Equipe-SJBots/amalinha/Files/Códigos/Projetos de outras pessoas/SEGUIDOR/circuito seguidor.png

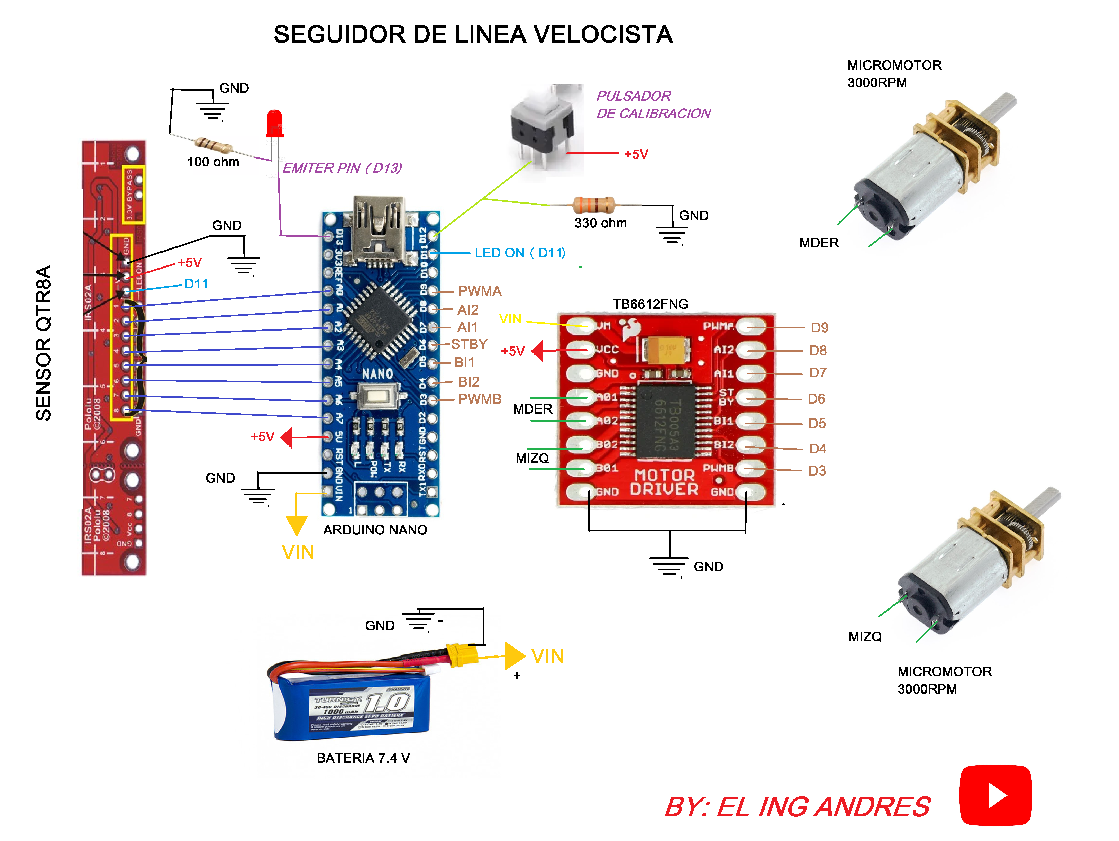
Files/Códigos/Projetos de outras pessoas/SEGUIDOR/circuito seguidor.png
