Equipe-SJBots/amalinha/README.md

# seguidor-de-linha
Códigos para o robô seguidor de linha
