Equipe-SJBots/amalinha/Files/Códigos/Projetos de outras pessoas/5IR-2Motores/README.md

# Line-Follower-Robot-using-5-Channel-IR

This github include the complete code and circuit diagram of the Line follower Project.
If you find the motors running in a wrong direction than just reverse the connection of the motors.
Queries can be mailed us on 2idiotsofengineering@gmail.com

- [Source](https://github.com/himanshus2847/Line-Follower-Robot-using-5-Channel-IR)
