Equipe-SJBots/amalinha/Files/Códigos/Projetos de outras pessoas/3 advanced_pid_control___bluetooth_communication/a.md

# Fonte

- [Hackster](https://www.hackster.io/anova9347/line-follower-robot-with-pid-controller-cdedbd)
