Equipe-SJBots/amalinha/Files/Códigos/Projetos de outras pessoas/PID-Line-Follower-Robot-main/source.md

# Fonte

- [Techno](https://github.com/theTechnowright/PID-Line-Follower-Robot)
