Equipe-SJBots/amalinha/Files/Códigos/Projetos de outras pessoas/5IR-2Motores/Diagrama.png

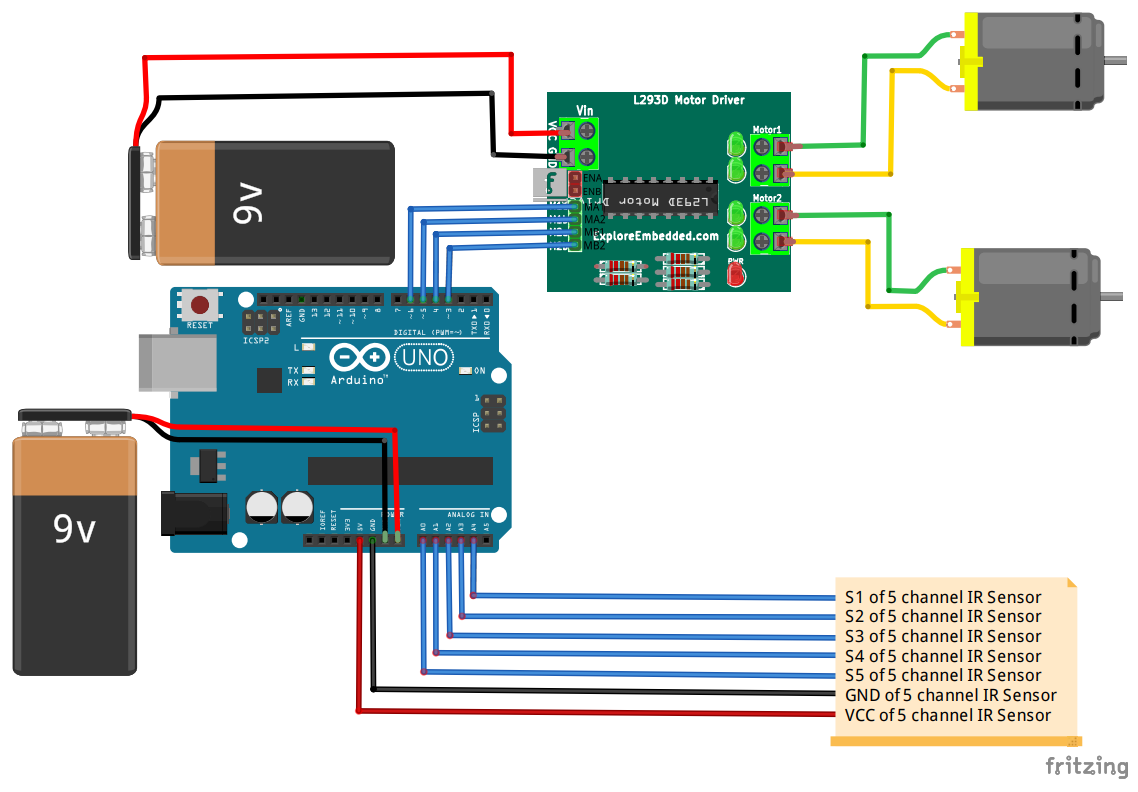
Files/Códigos/Projetos de outras pessoas/5IR-2Motores/Diagrama.png
