Equipe-SJBots/amalinha/Files/Esquema elétrico/20231111-DiagramaElétrico-Amalinha-5IR.png

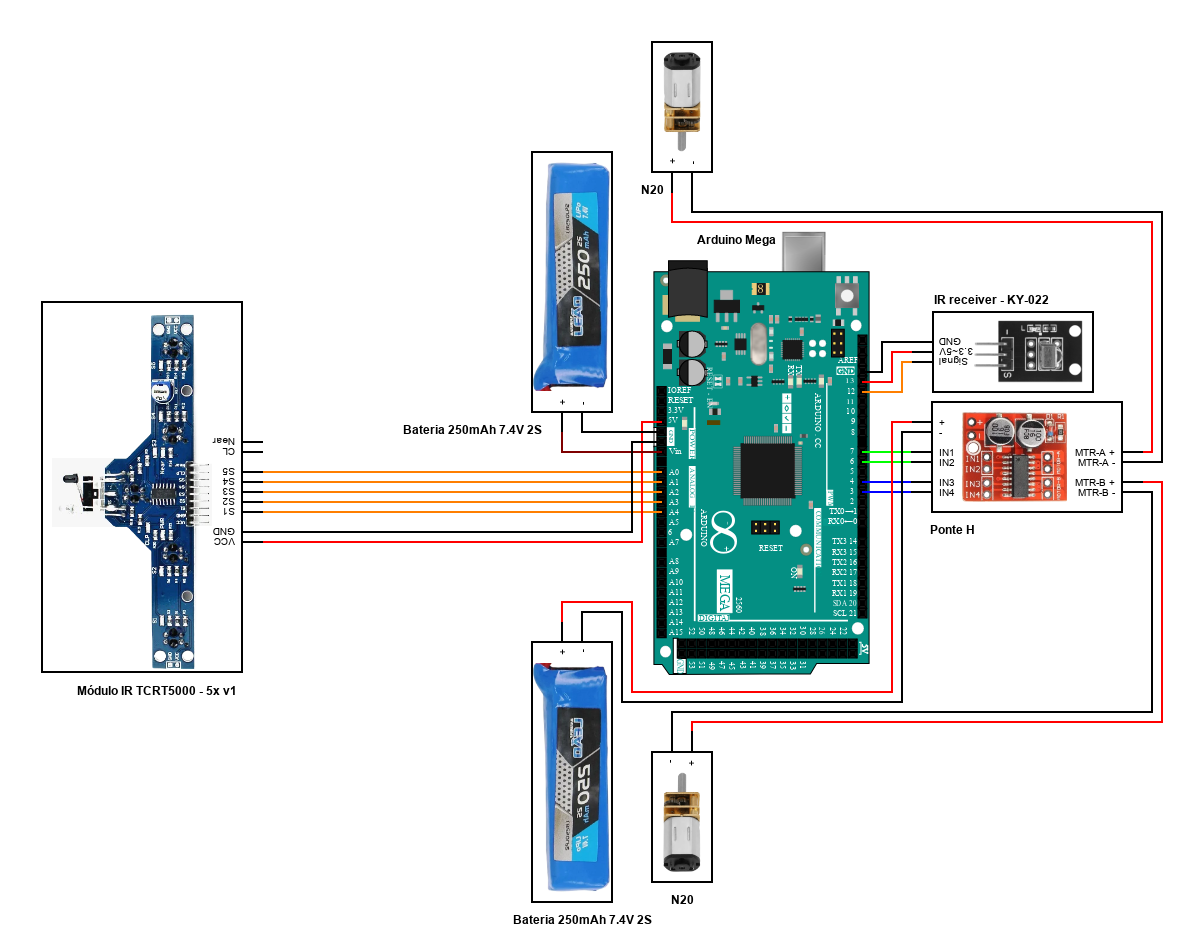
Files/Esquema elétrico/20231111-DiagramaElétrico-Amalinha-5IR.png
