Equipe-SJBots/amalinha/Files/Modelos/caster wheel v2.step

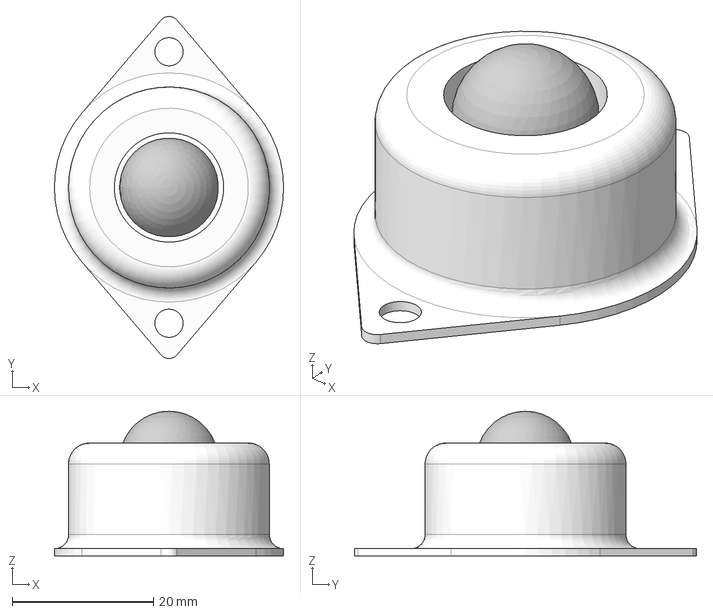
[picture p29: CAD file, 2023-11-14]
Files/Modelos/caster wheel v2.step
32.5 x 48.5 x 20.5 mm
Case
