Equipe-SJBots/amalinha/Files/Modelos/Caster Ball Wheel.STEP

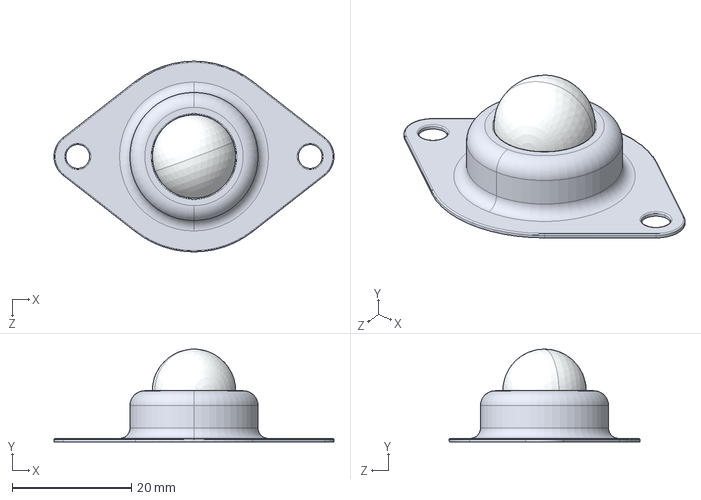
[picture p30: CAD file, 2023-11-14]
Files/Modelos/Caster Ball Wheel.STEP
47.0 x 15.6 x 32.0 mm
Wheel''s Body
Ball
