Equipe-SJBots/amalinha/(list of files, cad)

Other CAD files:
Files/Modelos/caster ball wheel.stl
Files/Modelos/caster wheel v2.stl
