Equipe-SJBots/amalinha/Files/Códigos/Projetos de outras pessoas/SEGUIDOR/IMPIRMIR/Untitled Sketch 2_etch_copper_bottom.pdf

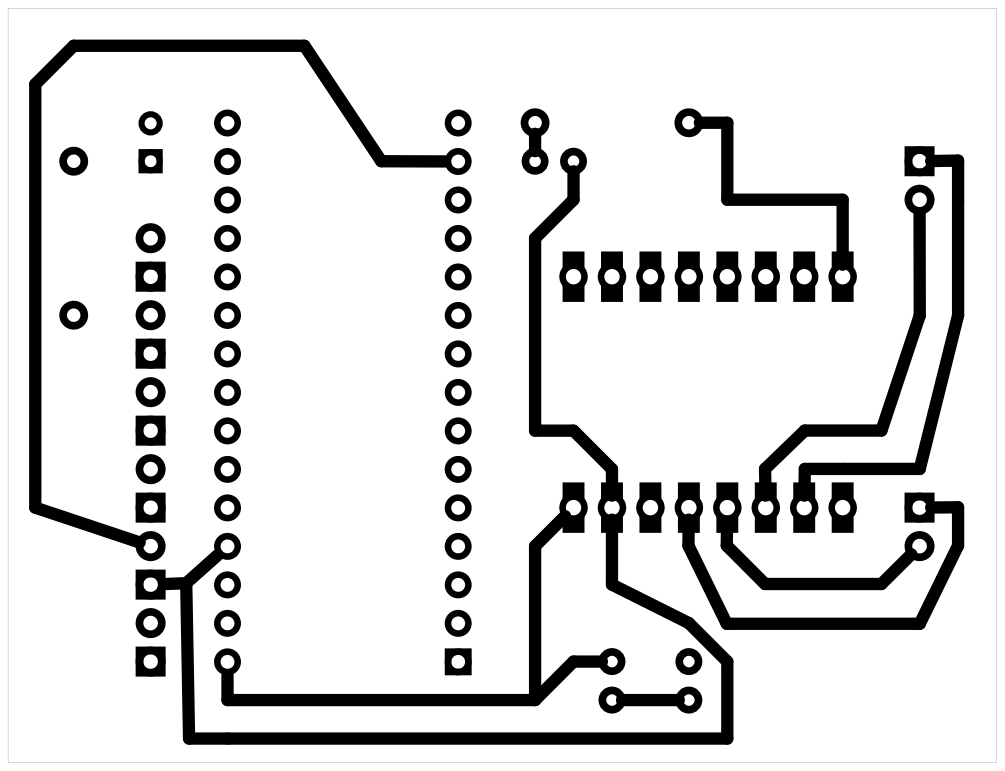
[picture p31: page 1]
