Equipe-SJBots/amalinha/Files/Códigos/Projetos de outras pessoas/SEGUIDOR/IMPIRMIR/Untitled Sketch 2_etch_copper_bottom_mirror.pdf

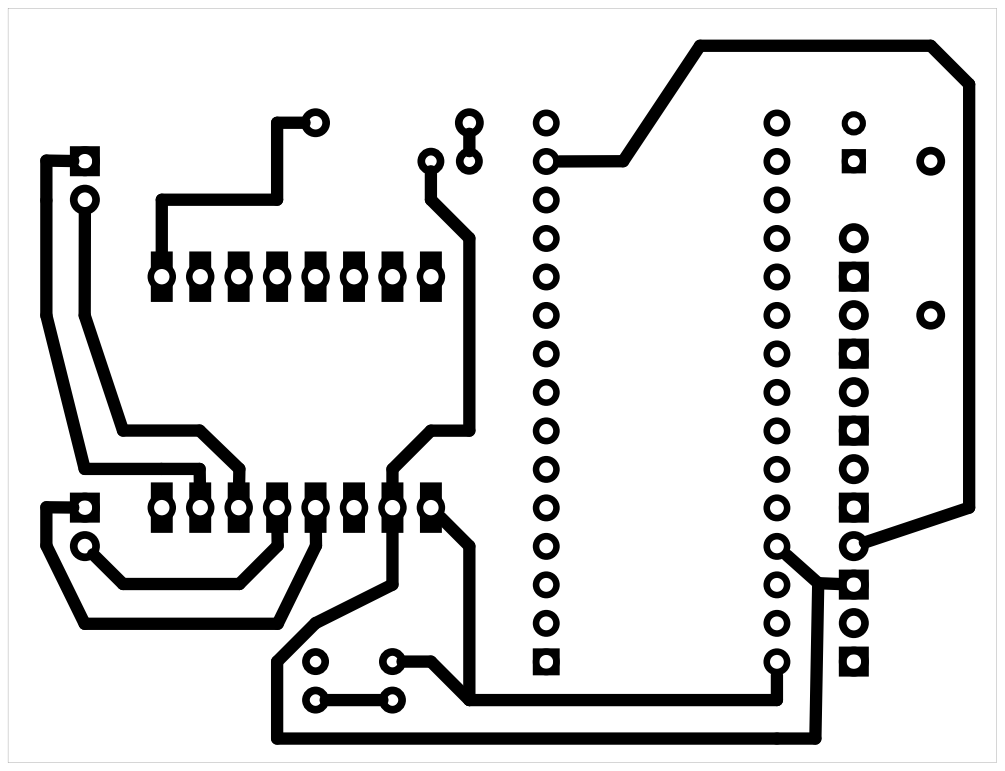
[picture p32: page 1]
