Equipe-SJBots/amalinha/Files/Códigos/Projetos de outras pessoas/SEGUIDOR/IMPIRMIR/Untitled Sketch 2_etch_copper_top.pdf

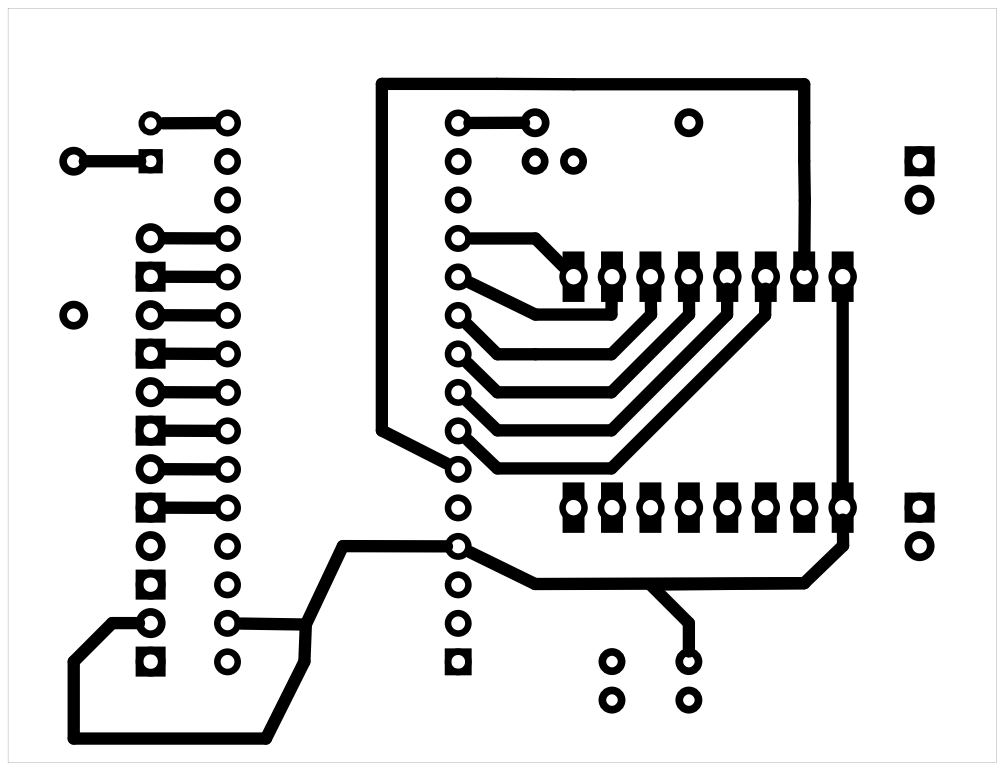
[picture p33: page 1]
