Equipe-SJBots/amalinha/Files/Códigos/Projetos de outras pessoas/SEGUIDOR/IMPIRMIR/Untitled Sketch 2_etch_copper_top_mirror.pdf

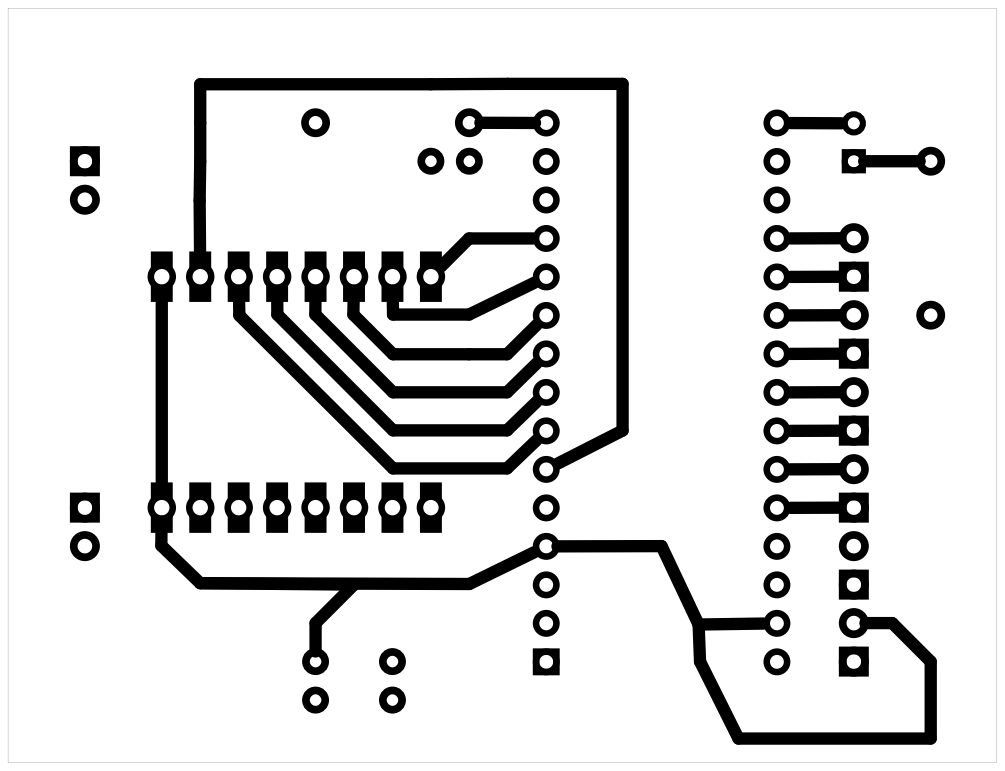
[picture p34: page 1]
