Equipe-SJBots/amalinha/(list of files, drawings)

Other design files:
Files/Códigos/Projetos de outras pessoas/SEGUIDOR/seguidor de linea 1.0.fzz
