Equipe-SJBots/amalinha/(commit log)

2023-10-04 mudança de nome
2023-10-05 Códigos Seguidor de linha
2023-10-09 some new codes
    [Line Follower PID-B_Cu.gbl, Line Follower PID-B_Mask.gbs, Line Follower PID-B_Paste.gbp, Line Follower PID-B_Silkscreen.gbo, Line Follower PID-Edge_Cuts.gm1, Line Follower PID-F_Cu.gtl, Line Follower PID-F_Mask.gts, Line Follower PID-F_Paste.gtp]
2023-10-24 teste2
    para joão
2023-11-09 adicionando emojis 😎
2023-11-13 adição de novo projeto
    [seguidor de linea 1.0.fzz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]
2023-11-13 Adição de pinos pro módulo vermelho
    modificação de código existente para adicionar os 8 pinos do módulo vermelho.
2023-11-13 duplicação de arquivos
    [Line Follower PID-B_Cu.gbl, Line Follower PID-B_Mask.gbs, Line Follower PID-B_Paste.gbp, Line Follower PID-B_Silkscreen.gbo, Line Follower PID-Edge_Cuts.gm1, Line Follower PID-F_Cu.gtl, Line Follower PID-F_Mask.gts, Line Follower PID-F_Paste.gtp]
2023-11-13 Remoção de duplicatas + renomeação
    [Line Follower PID-B_Cu.gbl, Line Follower PID-B_Mask.gbs, Line Follower PID-B_Paste.gbp, Line Follower PID-B_Silkscreen.gbo, Line Follower PID-Edge_Cuts.gm1, Line Follower PID-F_Cu.gtl, Line Follower PID-F_Mask.gts, Line Follower PID-F_Paste.gtp]
2023-11-13 possivel código de herick
2023-11-14 Rodas Bobas
    [Caster Ball Wheel.STEP, caster ball wheel.stl, caster wheel v2.step, caster wheel v2.stl]
2023-11-15 2 pinos por motor
2023-11-15 joão, ta incompleto, ele recebe sinal
    preciso saber qual sinal será dado para o "start" e qual será dado para "stop" com isso precisarei da ajuda de quem estiver presente no lab para testar, tem um arduino no armário 3 prontinho só pegar o computador "marcelo" e usar a biblioteca "IRremote" e colocar a programação.
    com isso após saber quais sinais serão usados preciso da ajuda de joão para me auxiliar no if this do that
2023-11-15 voltando às velocidades padrão
2023-11-15 Versão PID do Código
2023-11-17 implementando PID
2023-11-18 PID Image
2023-11-18 PID Adjusting
